jimmo/quokka/hardware/doc/pyboard-pins.jpg

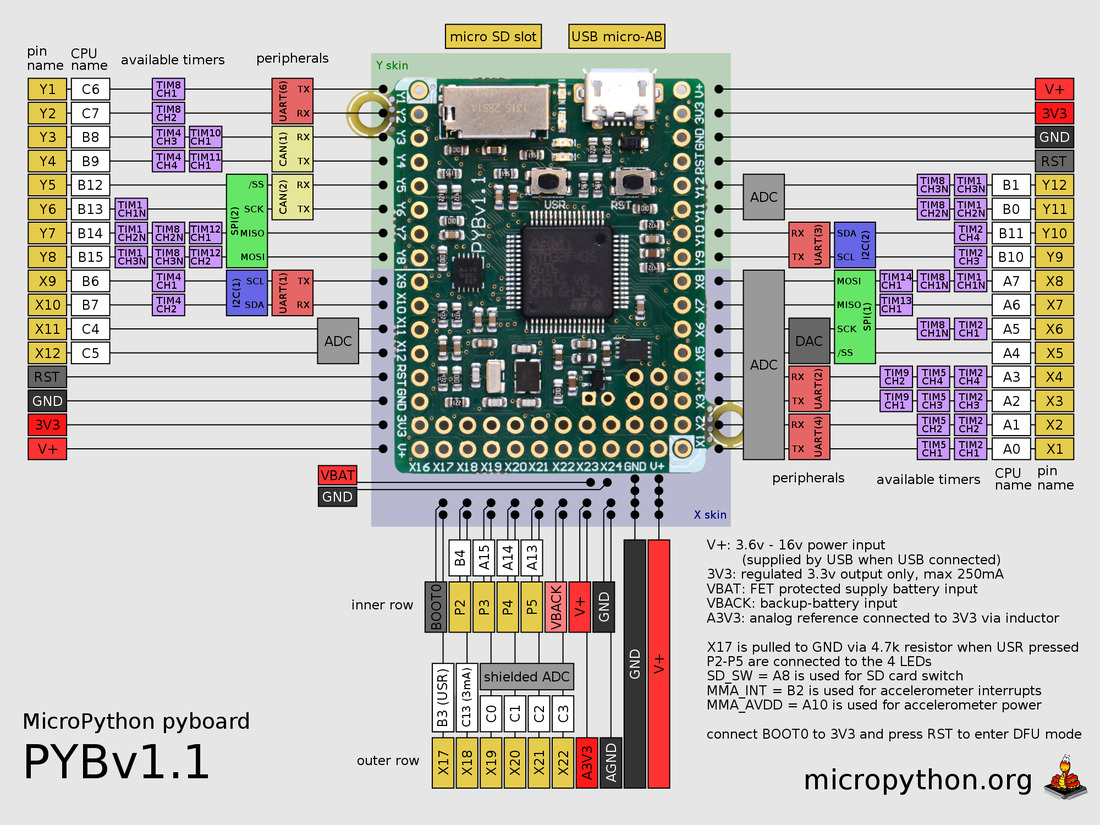
hardware/doc/pyboard-pins.jpg
