jimmo/quokka/hardware/quokka.pdf

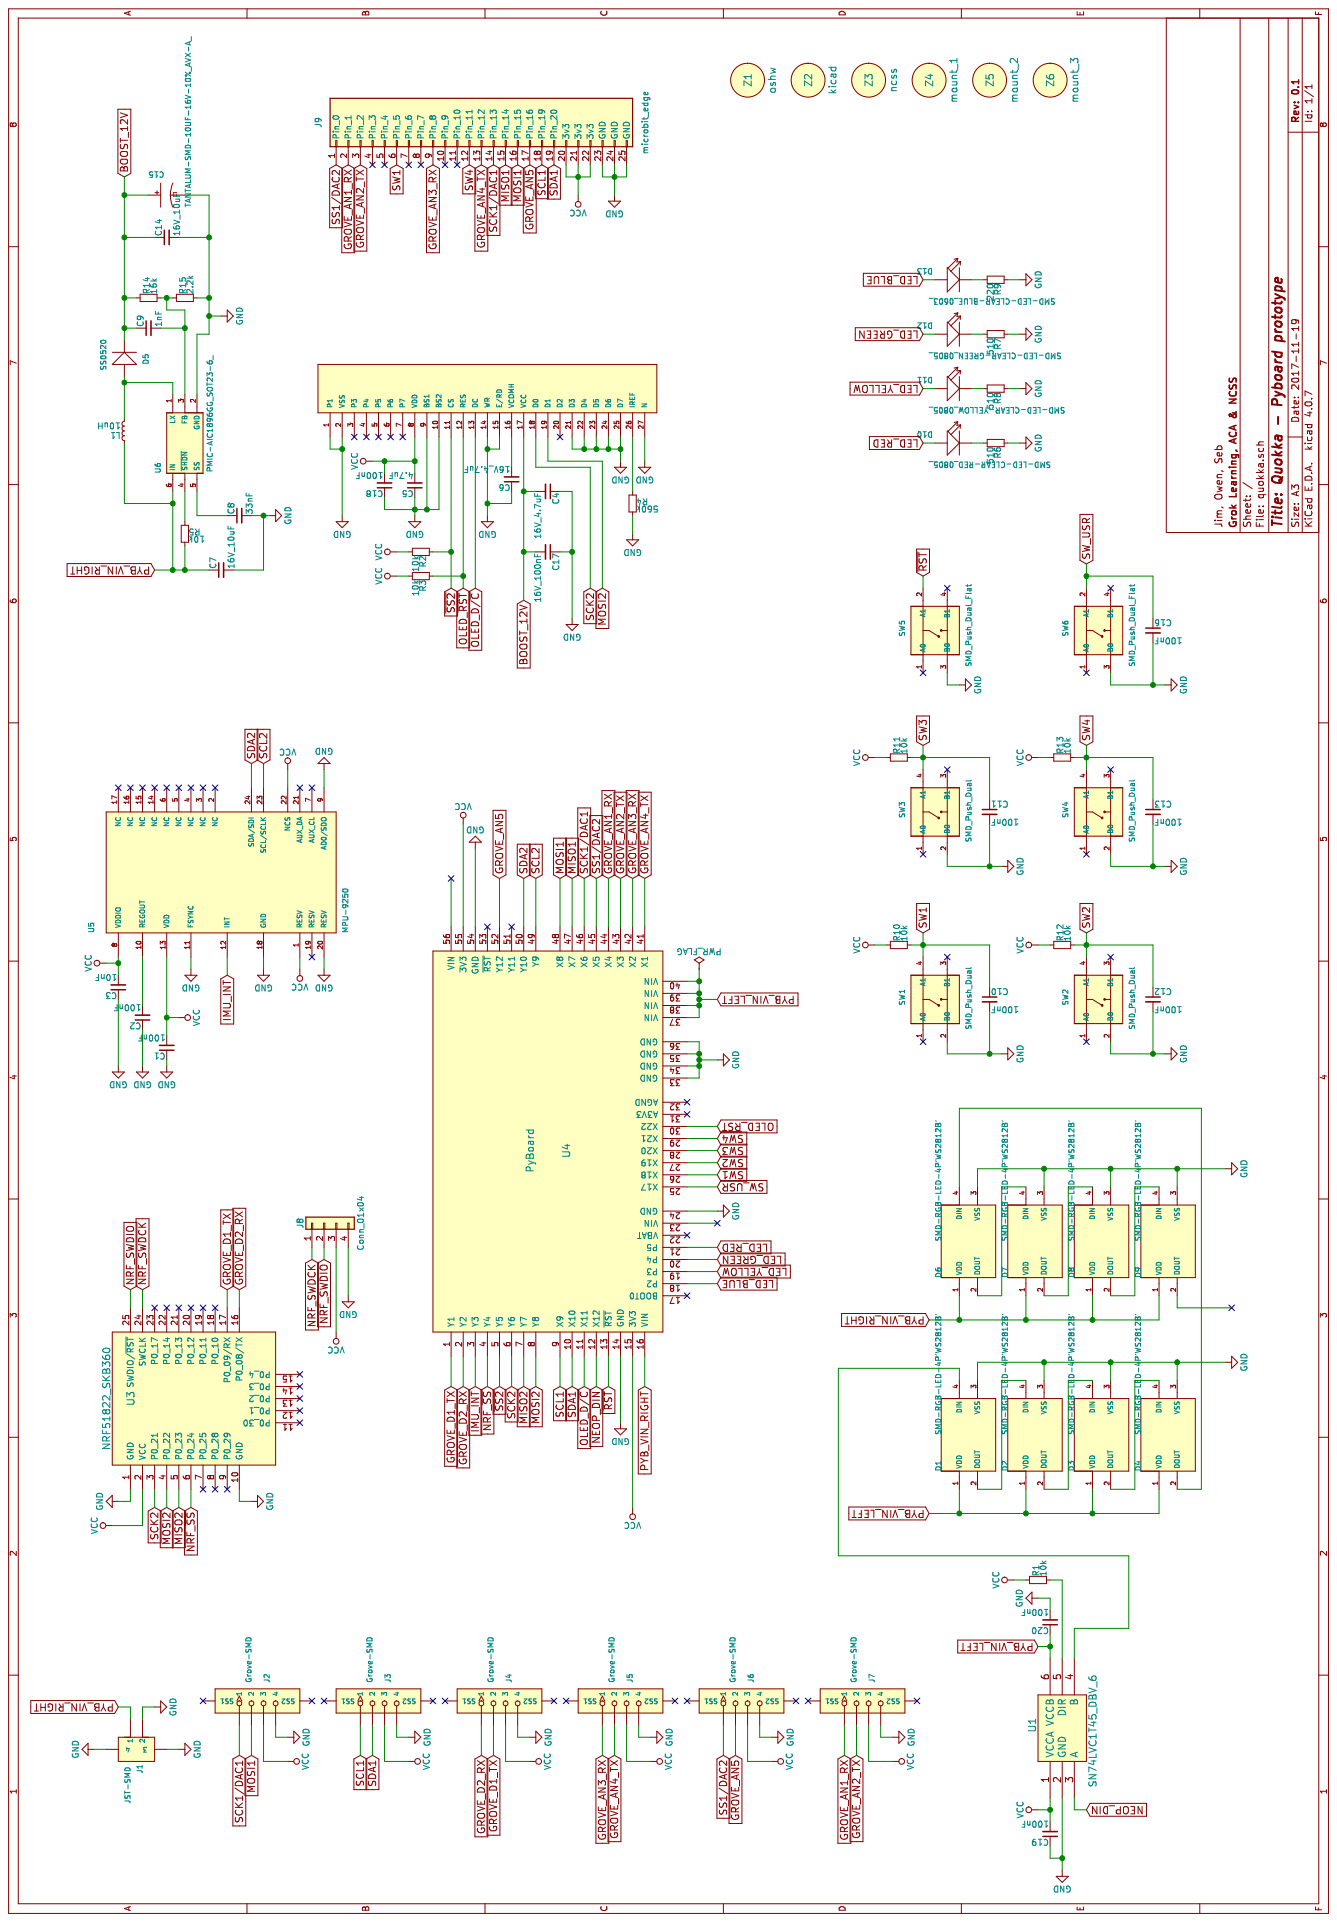
[picture p2: page 1]
