jimmo/quokka/(commit log)

2017-10-10 pyboard skin
    [quokka.kicad_pcb, quokka.sch]
2017-10-11 Add LSM303C and NRF51822
    [quokka.sch]
2017-10-11 Add comments.
    [quokka.sch]
2017-11-14 Add Seeed OPL parts.
    Add all footprints (using Eagle files).
    Add component library for the OLED display and IMU.
    [quokka.kicad_pcb, quokka.sch]
2017-11-15 Fix pins on pyboard symbol. Add pyboard footprint.
2017-11-15 Fix pin error in OPL for OLED. Add bend/down variants.
    [quokka.kicad_pcb, quokka.sch]
2017-11-15 Test side-by-side oled layout (bend and flat)
    [quokka.kicad_pcb, quokka.sch]
2017-11-15 Add micro:bit edge connector symbol.
    [quokka.sch]
2017-11-15 Add boost converter for oled.
    [quokka.sch]
2017-11-15 Add Grove SPI
2017-11-15 seeed oled schematic
    [quokka.sch]
2017-11-15 Add nrf51822 skylab footprint.
    Add docs pdfs.
    [quokka.sch]
2017-11-15 nrf wiring
    [quokka.sch]
2017-11-16 nc some pins on the imu
    [quokka.sch]
2017-11-16 Add skb360 footprint
    [quokka.kicad_pcb, quokka.sch]
2017-11-16 Add WS2182B, LEDs
    [quokka.kicad_pcb, quokka.sch]
2017-11-16 Add NCSS logo.
    [quokka.kicad_pcb, quokka.sch]
2017-11-17 Add mounting holes. Set design rules.
    [quokka.kicad_pcb]
2017-11-17 Start adding Seeed MPN/SKU attrs
    [quokka.csv, quokka.kicad_pcb, quokka.sch]
2017-11-17 Start layout for caps
    [quokka.kicad_pcb, quokka.sch]
2017-11-18 More BOM and PCB layout
    [quokka.csv, quokka.kicad_pcb, quokka.sch]
2017-11-21 Update micro:bit edge connector width
    [quokka.kicad_pcb, quokka.sch]
2017-11-21 More board layout.
    Lots of pin assignments.
    Level shifter.
    OLED checks.
    Microbit pin numbering.
    Digital/analog grove.
    [quokka.kicad_pcb, quokka.sch]
2017-11-21 Update grove footprints. Add all components to layout.
    [quokka.kicad_pcb, quokka.sch]
2017-11-21 More layout
    [quokka.kicad_pcb, quokka.sch]
2017-11-21 Add seeed button symbols. Start routing.
    [quokka.kicad_pcb, quokka.sch]
2017-11-21 Start again with tracks
    [quokka.kicad_pcb]
2017-11-21 Attempt 2 at routing
    [quokka.kicad_pcb, quokka.sch]
2017-11-21 More routing
    [quokka.kicad_pcb, quokka.sch]
2017-11-22 Fix issues that Seb raised.
    [quokka.kicad_pcb, quokka.sch]
2017-11-22 Make ERC (almost) pass. (Just pwoer/gnd stuff)
    [quokka.sch]
2017-11-22 Signal routing first pass.
    [quokka.kicad_pcb, quokka.sch]
2017-11-22 Down to 12 unconnected nets.
    [quokka.kicad_pcb, quokka.sch]
2017-11-22 Down to 3
    [quokka.kicad_pcb, quokka.sch]
2017-11-22 Finished routing!!
    [quokka.kicad_pcb, quokka.sch]
2017-11-22 Fix silkscreen
    [quokka.kicad_pcb]
2017-11-23 Fix mask for copper ncss logo. Add metadata to layout. Add 'Quokka v0.1'
    [quokka.kicad_pcb]
2017-11-23 Add neopixel and LED labels to silkscreen.
    [quokka.kicad_pcb]
2017-11-23 Move some things that were too close to edges
    [quokka.kicad_pcb]
2017-11-23 Fixes to get ready for upload to Seeed.
    Changed IREF to 560k. (3.3V instead of 5V).
    Changed the boost converter voltage divider to 16k/2.2k -- this
    gives an output of 10.15V instead of 10.25V but the parts are in the
    OPL.
    Changed the blue LED to 0603. Didn't have blue in OPL in 0805. Kept the
    others in 0805 (there's no red in 0603...).
    Changed most of the resistors to 0603 (to match what was in OPL).
    Add a script to generate a gerber zip in a format for Seeed.
    [quokka.csv, quokka.kicad_pcb, quokka.sch]
2017-11-24 Seeed's C0603 had the ref on the wrong layer. Fix up a few more silkscreen issues from switching to 0603 resistors.
    [quokka.kicad_pcb, quokka.sch]
2017-11-26 Update 16V cap for C14
    [quokka-full.csv, quokka.csv, quokka.kicad_pcb, quokka.sch]
2017-11-28 Add right-angle adaptor.
    [microbit-adaptor.kicad_pcb, microbit-adaptor.sch]
2017-12-06 Update for 8-bit SPI
2018-01-06 Reorg. Start implementing quokka.py
    [microbit-adaptor.kicad_pcb, microbit-adaptor.sch, quokka-full.csv, quokka.csv, quokka.kicad_pcb, quokka.sch]
2018-01-12 Start implementing PWM/DAC
2018-01-13 Fix missing parameter in text when not scaled
    [quokka.py]
2018-03-01 Fix button ordering. Add comments. Add image demo.
    [quokka.py, youre-welcome.py]
2018-03-02 Fixed quokka module bug in display demo. Added a neopixel for usr button in the buttons-display-neopixels demo.
    [buttons-display-neopixels.py]
2018-03-03 Make update.sh more general
    - Allow setting volume name, in case we are using an SD card
    - Copy libraries when given -u flag
2018-03-04 Strip comments from drivers
2018-09-29 Add accelerometer-controlled maze demo
